fidel-makatia/Aurora_GPU/docs/img/aurora_architecture.png

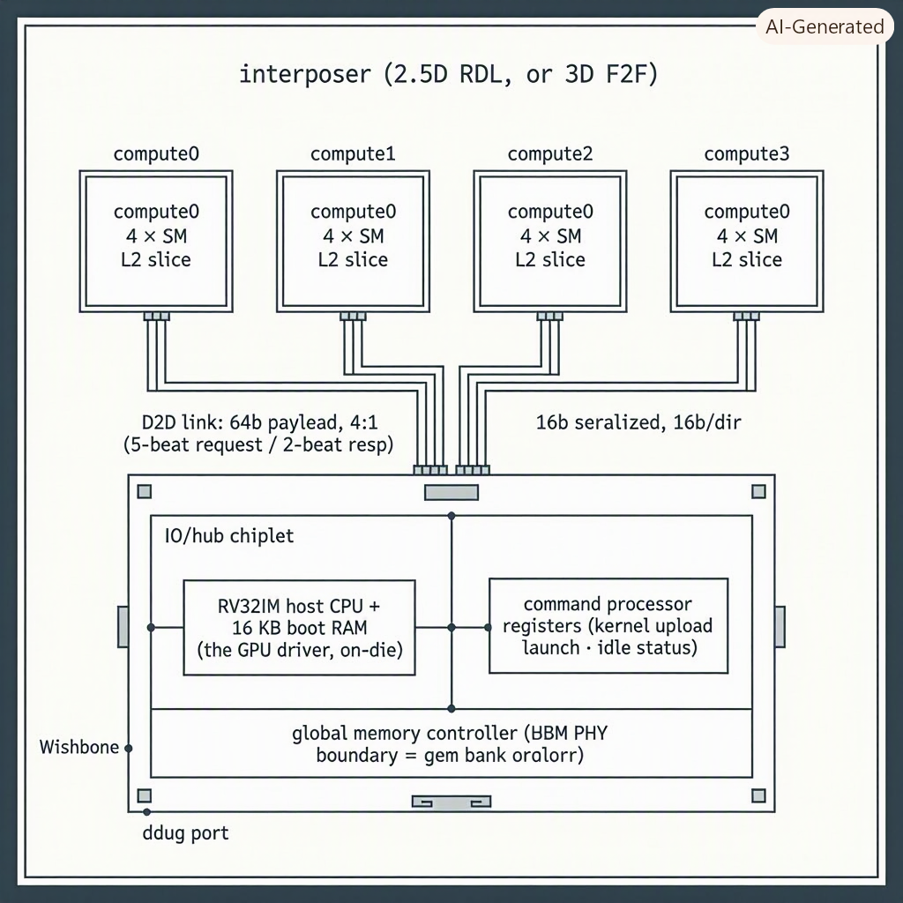
docs/img/aurora_architecture.png
