fidel-makatia/Aurora_GPU/(commit log)

2026-07-14 Aurora: chiplet SIMT GPU RTL for ASAP7 (smoke PASS)
    1 hub + 4 compute chiplets x 4 SM x 8 warps x 32 lanes = 512 SIMT lanes.
    SM (warp sched + 32-lane SIMD ALU + banked RF + shared mem + LSU + barriers),
    L2 slice, 16b D2D serdes-lite links, 2.5D top. 20-op ISA. Vector-add smoke
    test passes through full SM->L2->D2D->hub round-trip. Genus ASAP7 per-chiplet
    synthesis script (1 GHz RVT TT, reuses SenseEdge CCS libs).
    [aurora_top_2p5d.v, compute_chiplet.v, d2d_link.v, io_chiplet.v, l2_slice.v, regfile.v, simd_alu.v, sm_core.v]
2026-07-26 Ansys Q3D D2D study: 3D F2F ubump (2.69fJ/bit, 0.001% xtalk) vs 2.5D RDL 200um-2mm (3.8-36.5fJ/bit, ~25% xtalk); C matrices + summary
    [aurora_d2d_summary.csv]
2026-07-26 GPU v2: SRAM register file (12x 1R1W 272x256 banks, 3 read copies, issue-stage sync reads), WB lane-merge replaces write masking, 3-deep pipeline interlock (also fixes v1 single-warp RAW hazard), LSU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
    [regfile_flops.v, regfile_sram.v, sm_core.v, sram_1r1w_272_256_asap7.v]
2026-07-27 Dev-grade README (architecture diagrams, full metrics), MIT license, genericize flow paths
2026-07-27 RISC-V host CPU on-die: Aurora is now a complete SoC
    - rtl/riscv_core.v: RV32I + M-multiply, multi-cycle (FETCH/EXEC/MEM/WB),
    single bus master; unit-tested (RV_UNIT_PASS)
    - io_chiplet: internal hub-bus arbiter (external Wishbone keeps priority,
    now a bring-up/debug port), 16KB boot RAM, result mmio, cpu_en strap;
    CPU sees the same command map (gmem/imem-upload/launch/status)
    - fw/cmd_proc.S + tools/rvasm.py (self-contained two-pass RV32 assembler):
    firmware writes vectors, uploads the SIMT kernel to all 16 SMs, launches
    2 warps/SM, polls idle, verifies c[i]=a[i]+b[i] on-die, reports mmio
    - tb/tb_aurora_riscv.v: self-boot test, ZERO external bus activity --
    AURORA_RISCV_PASS; leg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
    [aurora_top_2p5d.v, io_chiplet.v, riscv_core.v, tb_aurora_riscv.v, tb_aurora_smoke.v]
2026-07-28 Results: hub v3 synthesis (1 GHz MET, 0.120 mm², 4x smaller) + io_chiplet die P&R (941x941 um, WNS -0.126)
2026-07-30 d2d_link: reset tx_d in both directions (undriven-until-first-beat X poisoned gate-level hub simulation; found via VCD X-onset analysis)
    [d2d_link.v]
2026-07-30 io_chiplet: single write process for boot RAM
    A reg array written from two always blocks synthesizes into two parallel
    flop banks with shorted outputs (X wherever contents diverge -- i.e., on
    every written 1). Found at gate level via VCD X-onset census and structural
    cone tracing: firmware loaded through the hub port landed in one bank, CPU
    fetches read the shorted pair. RTL simulation cannot see this class.
    Third RTL bug found by GLS (after the v1 single-warp RAW hazard and the
    unreset d2d tx_d).
    [io_chiplet.v]
